StepRobotWhatAreYouDoing/Low-Profile-Belt-Tensioner-CE/step/1:4 BSPP Port Plug - Grainger 39a352.step

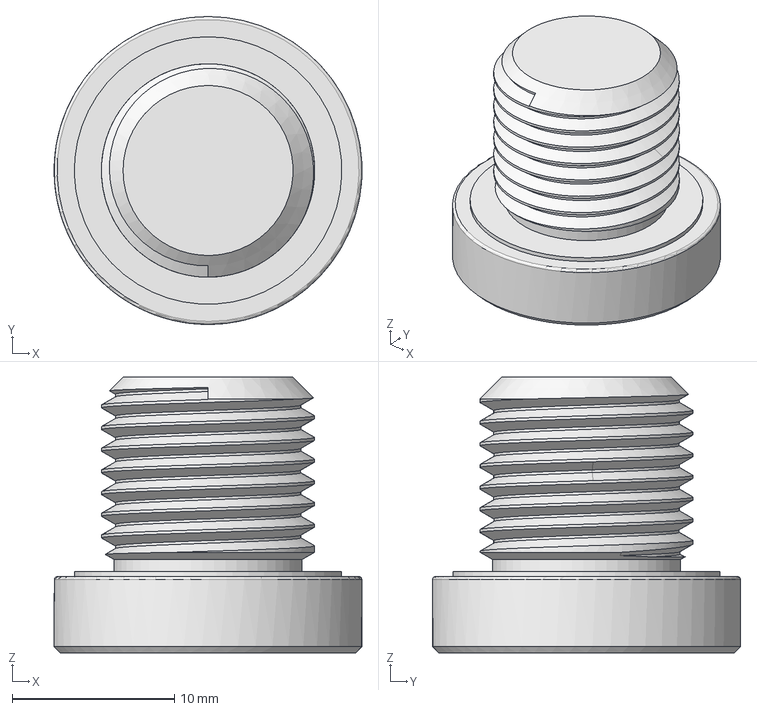
[picture p4: CAD file, 2025-11-24]
step/1:4 BSPP Port Plug - Grainger 39a352.step
19.0 x 19.0 x 17.0 mm
