StepRobotWhatAreYouDoing/Low-Profile-Belt-Tensioner-CE/stl/Belt Tensioner Block.stl

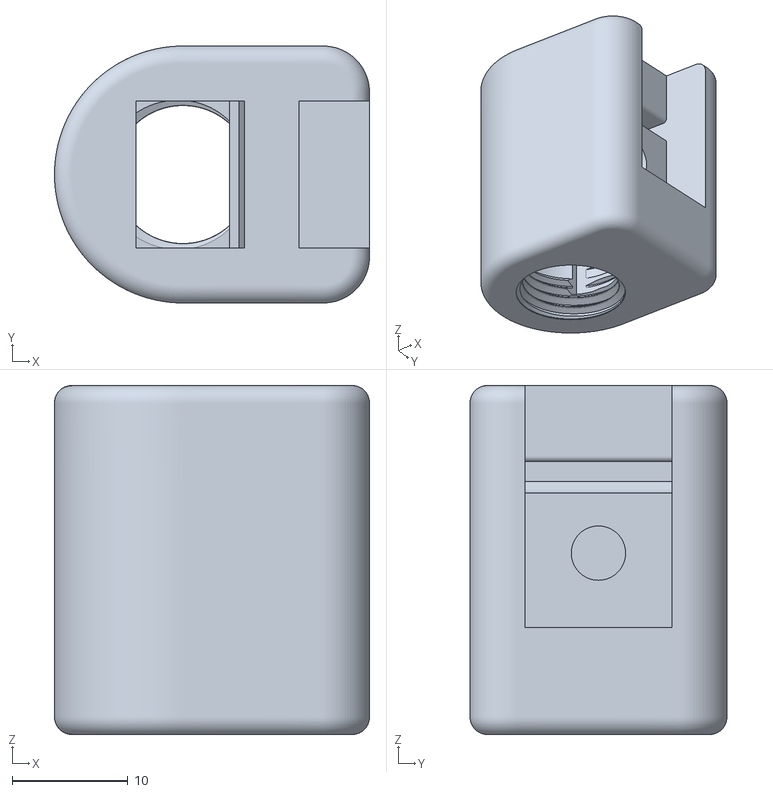
[picture p5: CAD file, 2025-11-24]
stl/Belt Tensioner Block.stl
27.3 x 22.2 x 30.2
