StepRobotWhatAreYouDoing/Low-Profile-Belt-Tensioner-CE/stl/Belt Tensioner Clasp.stl

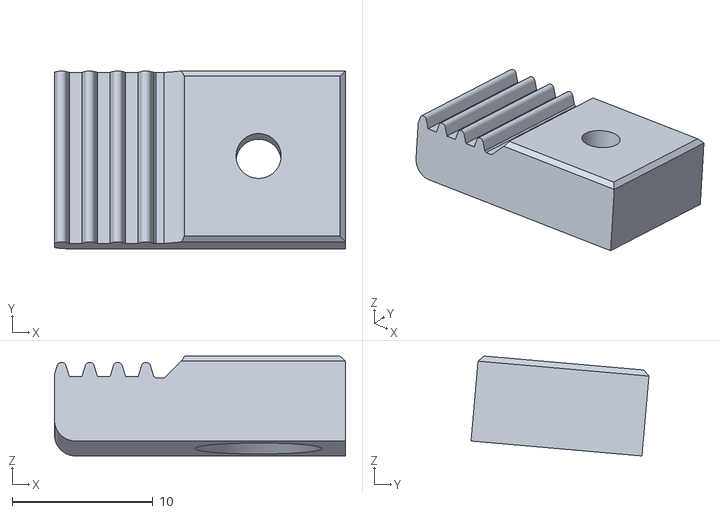
[picture p6: CAD file, 2025-11-24]
stl/Belt Tensioner Clasp.stl
20.7 x 12.7 x 7.11
