StepRobotWhatAreYouDoing/Low-Profile-Belt-Tensioner-CE/(list of files, cad)

Other CAD files:
fusion/1:4 BSPP Port Plug - Grainger 39a352.f3d
stl/1:4 BSPP Port Plug - Grainger 39a352.stl
